kevinhikaruevans/dell-d6000-usb-c-adapter/jlc_dell_adapter.kicad_sch

## KiCad design jlc_dell_adapter.kicad_sch (2024-11-12)

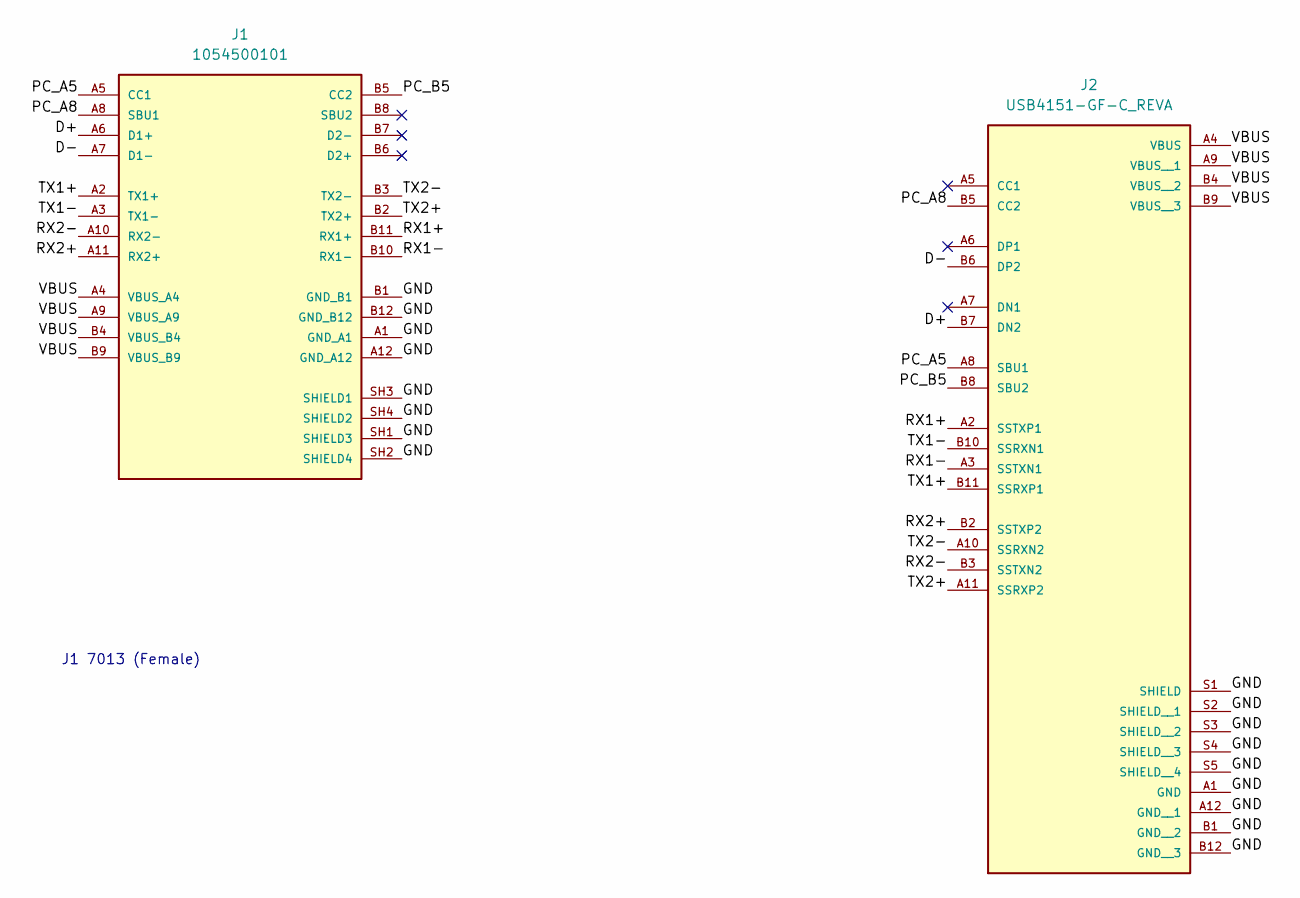
[picture p1: schematic jlc_dell_adapter.kicad_sch]

Parts:
J1: 1054500101; MOLEX_1054500101; PARTREV A7
J2: USB4151-GF-C_REVA; GCT_USB4151-GF-C_REVA; PARTREV A

Connections:
D+: J1.A6 (D1+), J2.B7 (DN2)
D-: J1.A7 (D1-), J2.B6 (DP2)
GND: J1.A1 (GND_A1), J1.A12 (GND_A12), J1.B1 (GND_B1), J1.B12 (GND_B12), J1.SH1 (SHIELD3), J1.SH2 (SHIELD4), J1.SH3 (SHIELD1), J1.SH4 (SHIELD2), J2.A1 (GND), J2.A12 (GND__1), J2.B1 (GND__2), J2.B12 (GND__3), J2.S1 (SHIELD), J2.S2 (SHIELD__1), J2.S3 (SHIELD__2), J2.S4 (SHIELD__3), J2.S5 (SHIELD__4)
PC_A5: J1.A5 (CC1), J2.A8 (SBU1)
PC_A8: J1.A8 (SBU1), J2.B5 (CC2)
PC_B5: J1.B5 (CC2), J2.B8 (SBU2)
RX1+: J1.B11 (RX1+), J2.A2 (SSTXP1)
RX1-: J1.B10 (RX1-), J2.A3 (SSTXN1)
RX2+: J1.A11 (RX2+), J2.B2 (SSTXP2)
RX2-: J1.A10 (RX2-), J2.B3 (SSTXN2)
TX1+: J1.A2 (TX1+), J2.B11 (SSRXP1)
TX1-: J1.A3 (TX1-), J2.B10 (SSRXN1)
TX2+: J1.B2 (TX2+), J2.A11 (SSRXP2)
TX2-: J1.B3 (TX2-), J2.A10 (SSRXN2)
VBUS: J1.A4 (VBUS_A4), J1.A9 (VBUS_A9), J1.B4 (VBUS_B4), J1.B9 (VBUS_B9), J2.A4 (VBUS), J2.A9 (VBUS__1), J2.B4 (VBUS__2), J2.B9 (VBUS__3)

Notes on the sheet:
J1 7013 (Female)
