kevinhikaruevans/dell-d6000-usb-c-adapter/(threads)

Thread 2 (2023-02-21):

pcb size

Td62, 2023-02-21:
Can you provide small pcb data
May I ask if you made the two type c adapter boards yourself? Can you provide the pcb for data or purchase links?
:)

kevinhikaruevans, 2023-02-21:
This board is meant to be printed on flexpcb, but it does not work correctly. I'm not sure what the problem is and do not have the time or funding to figure it out

Closed 2023-02-21.

Thread 3 (2024-03-07):

Redo this

kevinhikaruevans, 2024-03-07:
I think I made an error in the schematic. On the working breadboard version, I had two cables (on cable on each side) and I don't think I accounted for that. On the kicad version, there was only a single cable attached. Since the cables cross the rx/tx pairs, I would be crossing them twice with two cables.

I think I should try digging up this project again if I can find my old dock.

kevinhikaruevans, 2024-04-30:
Alright, found the old dock and maybe figured it out. So many problems.

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

kevinhikaruevans, 2024-04-30:
Next things to do:

- [ ] better understand how the sbu pin works
- [ ] test slow speed transfers, maybe see if GbE actually works or if display port does anything
- [ ] find turnkey service, get supported components - JAE? amp? gct?
- [ ] get footprints for type c connector into kicad
- [ ] sketch out schematic
- [ ] remember how to do design rules
- [ ] layout boards
- [ ] submit order, etc.

kevinhikaruevans, 2024-04-30:
There is a 1 cm hole that can be populated with a USB-C receptacle. I think I can create a 3D-printed receptacle to populate it but it'll be a very tight fit. Maybe I'll ignore this requirement for now.

kevinhikaruevans, 2024-05-01:
Test board order via jlcpcb - eta several weeks. Using the GCT connectors again but might try a different design later on.

kevinhikaruevans, 2024-05-02:
Via size was increased to 0.3mm, via diameter was changed to 0.5mm. JLCPCB increased the size and I should prob reflect that on the PCB file

kevinhikaruevans, 2024-05-06:
Update: the GCT part cannot be sourced by JLCPCB. Will have to change the design to work with an existing part

kevinhikaruevans, 2024-05-06:
Ordered GCT parts through JLCPCB's global sourcing. ETA May 23.

In the meantime, I may try using the dg-switch and lian-xintech parts but it would require a redesign :/

kevinhikaruevans, 2024-05-23:
First test board arrived and it works (sorta).

* Lights up correctly, shows up in device manager
* Ethernet works
* Audio device shows up
* Charges/negotiates 50W delivery

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

Unfortunately, it looks like both the plug and receptacle works only in a single direction. This might be how it originally was, I'm not sure. But I can flip the plug on the PC-side and it works fine in either direction, so I'm pretty stumped. But I'll try a few things on the breadboard and see if I can figure it out that way.

Also the GbE seems to cap out around 500 Mbit, which is slower than my other (non-dell) dock. I'm not sure if this is a problem in the differential pairs and the physical layout, or if it's a limitation of the dock, or a bad pair somewhere. I'm also wondering if the plug side should be using the A-side D pairs instead.

Next steps:

- [ ] Put it back on the breadboard
- [ ] Try out different configurations.
- [ ] Try out flipping the orientation of the A/B side
- [ ] Try and understand wtf's happening with the A5/A8 signals. Do I need to correct these?
- [ ] Should GND be connected to the shield? Probe the original board
- [ ] **IF** there are schematic changes, do those
- [ ] Redesign board w/ flex PCB
   - [ ] increase power trace width, remove the power plane (maybe)
   - [ ] add mounting holes
- [ ] receptacle design in CAD

ETA 1-2 mo

kevinhikaruevans, 2024-05-29:
not sure how to calculate the impedance over a crosshatch gnd plane w/o either paying money or a ton of work.

it looks like pcbway has controlled impedance on flex pcbs though

enryson, 2024-07-14:
Hello.. i'm trying to modify directly on the board..
the photo diagram that you did is kinda confusing.

What pins are flipped?

kevinhikaruevans, 2024-07-22:
> Hello.. i'm trying to modify directly on the board.. the photo diagram that you did is kinda confusing.
>
> What pins are flipped?

Here's the working schematic:

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

The thing kinda works, going from `PC <-> USB C-C cable <-> J1 <-> J2 <-> D6000 dock`. However, although the connection from `PC <-> USB C-C cable` can be flipped, the connection between `USB C-C cable <-> J1` is unidirectional, which makes me think something in the schematic is wrong.

danielkappelle, 2024-08-20:
From what I've read online in several Reddit threads it appears that the cable is indeed unidirectional on the dock side. For example [here](https://www.reddit.com/r/AskElectronics/comments/e9ajah/comment/kz1rp10/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)

Maybe that helps

jinghuahe123, 2025-03-23:
Is this PCB available for sale anywhere/ where can I find the schematic?

kevinhikaruevans, 2025-03-23:
> Is this PCB available for sale anywhere/ where can I find the schematic?

Its not for sale as far as I know. The schematic is in the thread, can't guarantee it fully works though

jinghuahe123, 2025-03-24:
Sorry, I'm a newbie. How does the schematic work - do TX pins connect to corresponding TX pins or RX pins on the schematic (e.g. does TX1+ on J1 connect to TX1+ or RX1+ on J2)? Do the crosses at the end of a line mean No connect or connect to GND? Additionally where and how would I source this as a PCB? Thanks.

kevinhikaruevans, 2025-03-24:
> Sorry, I'm a newbie. How does the schematic work - do TX pins connect to corresponding TX pins or RX pins on the schematic (e.g. does TX1+ on J1 connect to TX1+ or RX1+ on J2)? Do the crosses at the end of a line mean No connect or connect to GND? Additionally where and how would I source this as a PCB? Thanks.

The Xs mean not connected (NC). You can open this in KiCAD but there is no board to have printed, it's just a schematic. If you open this, you will need to layout the design and have it printed.

Thread 4 (2024-04-30):

Receptacle design

kevinhikaruevans, 2024-04-30:
I think a female receptacle can fit within the existing hole if fitted upside down. It would be worth trying it out later down the road.

- [ ] capture measurements + design mockup
- [ ] 3d print mockup

kevinhikaruevans, 2024-04-30:
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

Terrible sketch but something like

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

kevinhikaruevans, 2024-05-02:
There's 8mm of clearance til it hits the heat sink edge. Maybe I'd need to rework this to use a shorter low profile connector since the GCT is nearly 9mm.

tuluongvm, 2025-01-14:
How if: we can use any type male C - male C cable to connect from inside to outside of box, then you can make a rubic adapter module (it contain your project result with female C - your mainboard - female C)
In this case, we must use 2 male C-C cables.

kevinhikaruevans, 2025-01-14:
It's certainly possible to do it that way

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

Thread 5 (2024-05-23):

Make sellable product

kevinhikaruevans, 2024-05-23:
Blocked by #3 #4

- [ ] find (local?) manufacturer for 3d printed tpu receptacle (if #4 pans out)
- [ ] calculate bom cost per adapter, assume free labor, no overhead, but w/ transaction fees
- [ ] design dumb validation jig. not sure yet of the best way to do this. maybe I use shift registers to check bits on each pin?
- [ ] create instructions, disclaimers

CraftCanna, 2025-08-08:
Google custom usbc cable pinout manufacturing
https://www.usbfirewire.com/e-custom.aspx
I'm sure someone could take the pinspec sheet and produce a small number for a pretty decent price. Pcb way. Sorry it's not an answer but at least now if I get Motivated again I can look into getting then custom made
