kevinhikaruevans/dell-d6000-usb-c-adapter/(commit log)

2020-12-13 increase pad size; panelize
    [DellAdapter_3.1.kicad_pcb, DellAdapter_3.1_Panel.kicad_pcb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]
2021-01-14 shrink tolerances on footprints
    [DellAdapter_3.1_PanelX3.kicad_pcb]
